ManSEDS-Satellites-and-Space-Systems/CubeSat-EPS/hardware/mount.FCStd

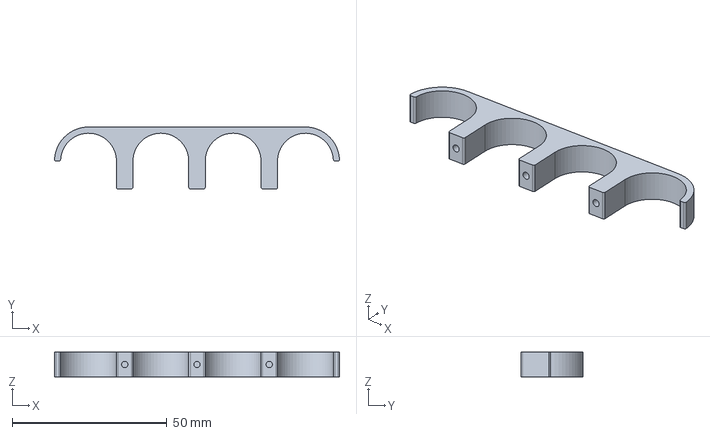
[picture p3: CAD file, 2026-10-23]
hardware/mount.FCStd
92.0 x 20.0 x 8.00 mm
