ManSEDS-Satellites-and-Space-Systems/CubeSat-EPS/hardware/schematic.pdf

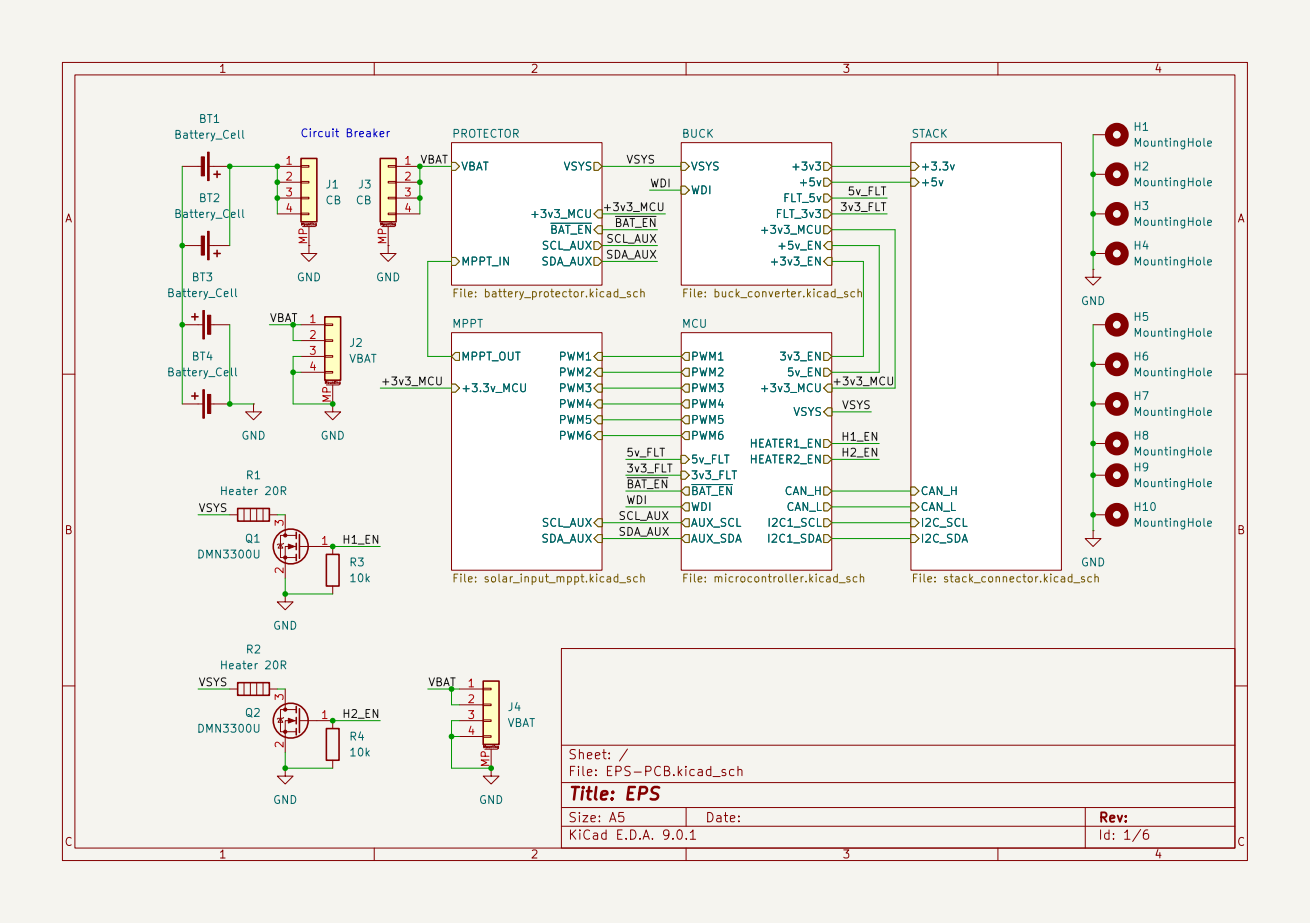
[picture p10: page 1]

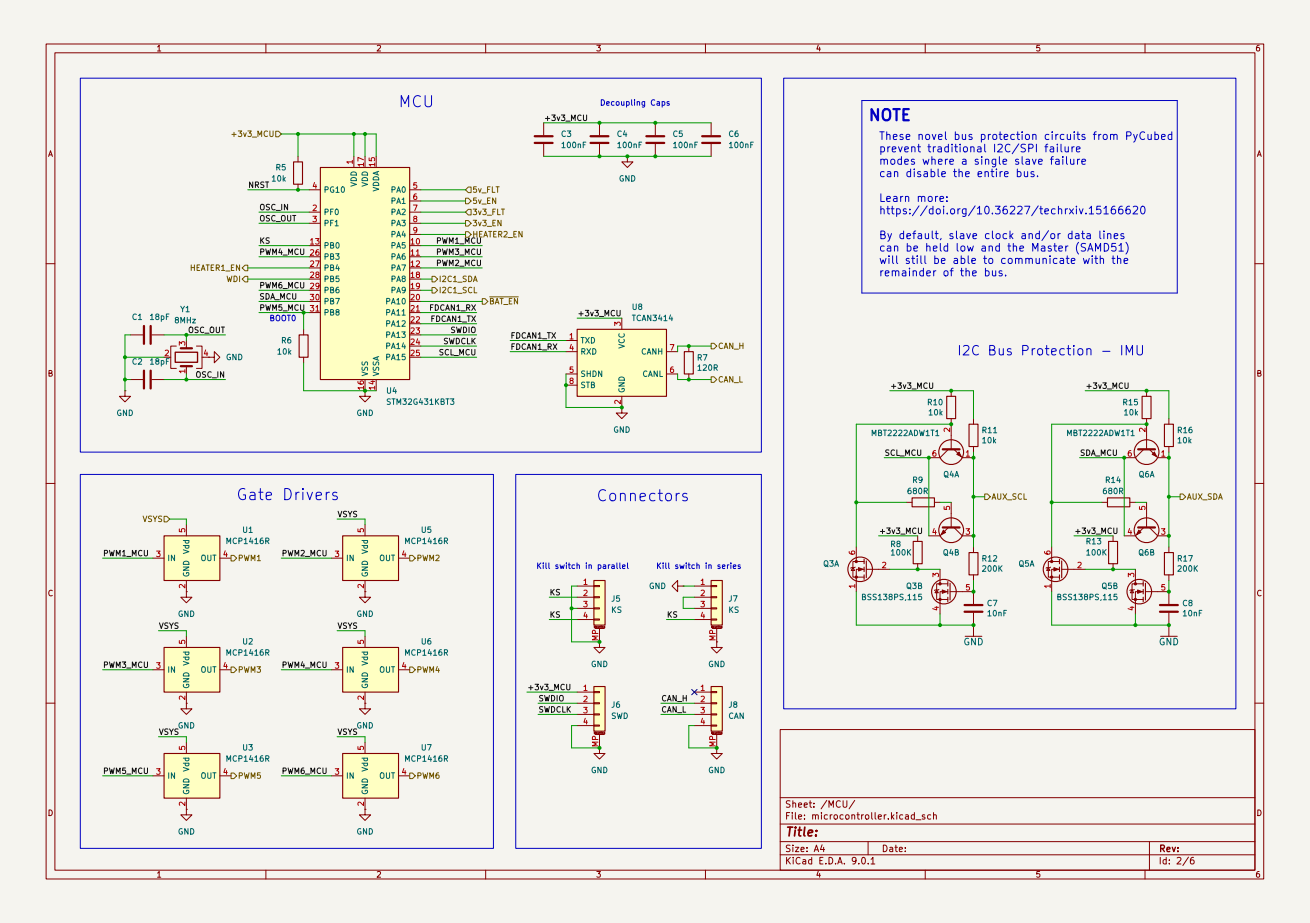
[picture p11: page 2]


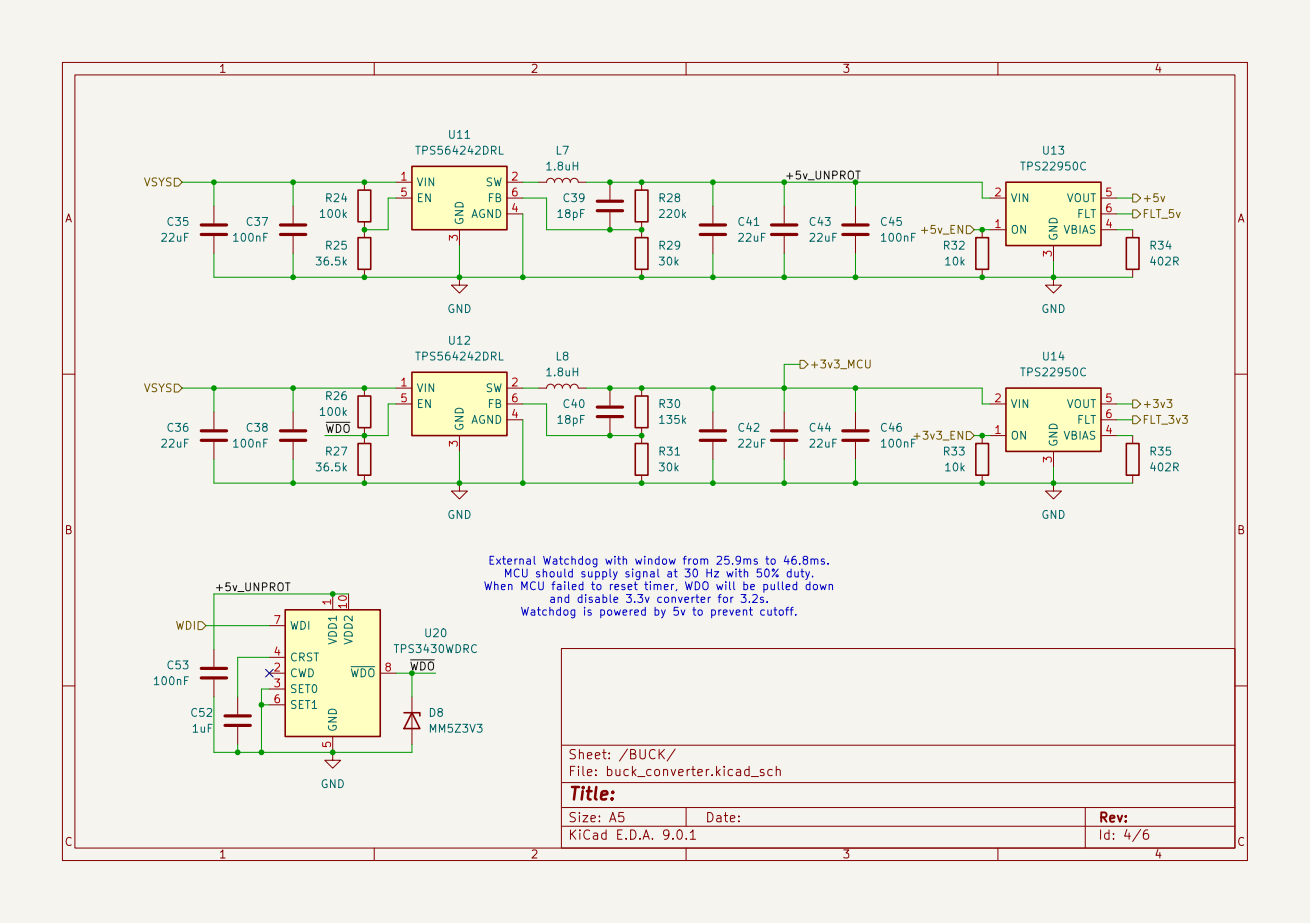
[picture p12: page 4]
