ManSEDS-Satellites-and-Space-Systems/CubeSat-EPS/hardware/EPS-PCB.kicad_pcb

## KiCad design hardware/EPS-PCB.kicad_pcb (2026-11-01)

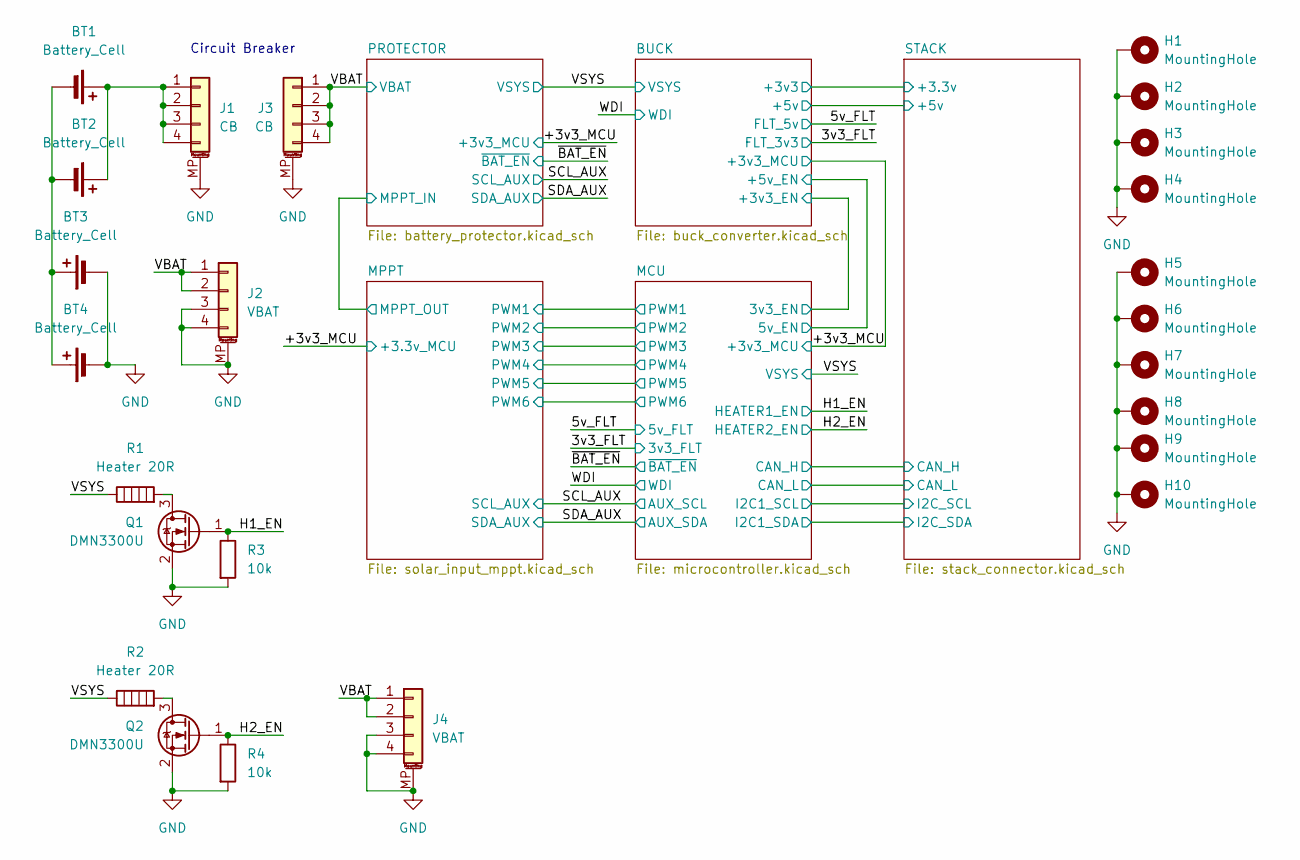
[picture p13: schematic EPS-PCB.kicad_sch, EPS]

Parts:
BT1, BT2, BT3, BT4: Battery_Cell; 18650-THT
H1, H2, H3, H4: MountingHole; MountingHole_3.2mm_M3_DIN965_Pad
H5, H6, H7, H8, H9, H10: MountingHole; MountingHole_2.7mm_M2.5_DIN965_Pad
J1, J3: CB; Molex_Pico-Lock_504050-0491_1x04-1MP_P1.50mm_Horizontal; Mouser Part Number 538-504050-0491
J2, J4: VBAT; Molex_Pico-Lock_504050-0491_1x04-1MP_P1.50mm_Horizontal; Mouser Part Number 538-504050-0491
Q1, Q2: DMN3300U; SOT-23; Mouser Part Number 621-DMN3300U-7
R1, R2: Heater 20R; R_Axial_DIN0617_L17.0mm_D6.0mm_P30.48mm_Horizontal; Mouser Part Number 279-4-2176793-0
R3, R4: 10k; R_0603_1608Metric; Mouser Part Number 603-AC0603DR-0710KL

Connections:
/H1_EN: Q1.1 (G), R3.1; also elsewhere on the board
/H2_EN: Q2.1 (G), R4.1; also elsewhere on the board
/VBAT: J2.1, J2.2, J3.1, J3.2, J3.3, J3.4, J4.1, J4.2; also elsewhere on the board
/VSYS: R1.1, R2.1; also elsewhere on the board
GND: BT3.2 (-), BT4.2 (-), H1.1, H2.1, H3.1, H4.1, H5.1, H6.1, H7.1, H8.1, H9.1, H10.1, J1.MP (MountPin), J2.3, J2.4, J2.MP (MountPin), J3.MP (MountPin), J4.3, J4.4, J4.MP (MountPin), Q1.2 (S), Q2.2 (S), R3.2, R4.2; also elsewhere on the board
unnamed: BT1.1 (+), BT2.1 (+), J1.1, J1.2, J1.3, J1.4
unnamed: BT1.2 (-), BT2.2 (-), BT3.1 (+), BT4.1 (+)
unnamed: Q1.3 (D), R1.2
unnamed: Q2.3 (D), R2.2

Notes on the sheet:
Circuit Breaker

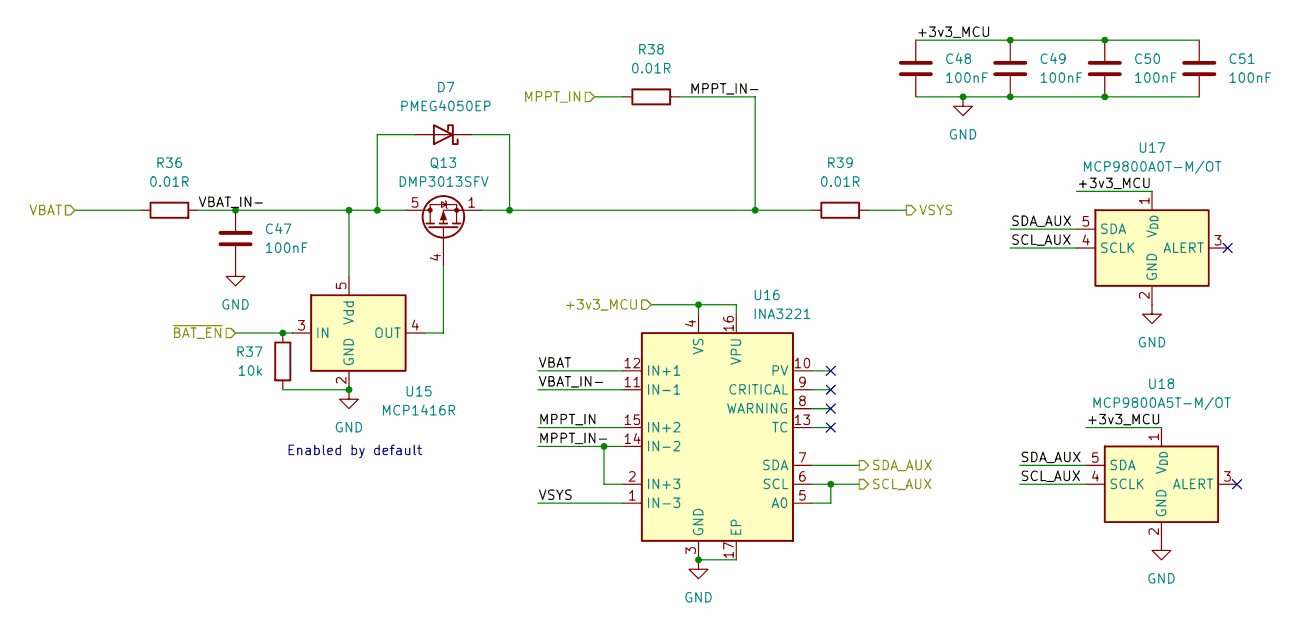
[picture p14: schematic battery_protector.kicad_sch]

Parts:
C47, C48, C49, C50, C51: 100nF; C_0603_1608Metric; Mouser Part Number 603-C0603JRX7R7BB104
D7: PMEG4050EP; D_SOD-128; Mouser Part Number 771-PMEG4050EP115
Q13: DMP3013SFV; Diodes_PowerDI3333-8; Mouser Part Number 621-DMP3013SFV-13
R36, R38, R39: 0.01R; R_0805_2012Metric; Mouser Part Number 603-PA0805FRF870R01L
R37: 10k; R_0603_1608Metric; Mouser Part Number 603-AC0603DR-0710KL
U15: MCP1416R; SOT-23-5; Mouser Part Number 579-MCP1416RT-E/OT
U16: INA3221; Texas_RGV0016A_VQFN-16-1EP_4x4mm_P0.65mm_EP2.1x2.1mm; Mouser Part Number 595-INA3221AIRGVR
U17: MCP9800A0T-M/OT; SOT-23-5; Mouser Part Number 579-MCP9800A0T-M/OT
U18: MCP9800A5T-M/OT; SOT-23-5; Mouser Part Number 579-MCP9800A5T-M/OT

Connections:
/+3v3_MCU: C48.1, C49.1, C50.1, C51.1, U16.4 (VS), U16.16 (VPU), U17.1 (V_{DD}), U18.1 (V_{DD}); also elsewhere on the board
/MPPT/MPPT_OUT: R38.1, U16.15 (IN+2); also elsewhere on the board
/PROTECTOR/MPPT_IN-: D7.1 (K), Q13.1 (S), Q13.2 (S), Q13.3 (S), R38.2, R39.1, U16.2 (IN+3), U16.14 (IN-2)
/PROTECTOR/VBAT_IN-: C47.1, D7.2 (A), Q13.5 (D), R36.2, U15.5 (Vdd), U16.11 (IN-1)
/SCL_AUX: U16.5 (A0), U16.6 (SCL), U17.4 (SCLK), U18.4 (SCLK); also elsewhere on the board
/SDA_AUX: U16.7 (SDA), U17.5 (SDA), U18.5 (SDA); also elsewhere on the board
/VBAT: R36.1, U16.12 (IN+1); also elsewhere on the board
/VSYS: R39.2, U16.1 (IN-3); also elsewhere on the board
/~BAT_EN: R37.1, U15.3 (IN); also elsewhere on the board
GND: C47.2, C48.2, C49.2, C50.2, C51.2, R37.2, U15.2 (GND), U16.3 (GND), U16.17 (EP), U17.2 (GND), U18.2 (GND); also elsewhere on the board
unnamed: Q13.4 (G), U15.4 (OUT)

Notes on the sheet:
Enabled by default

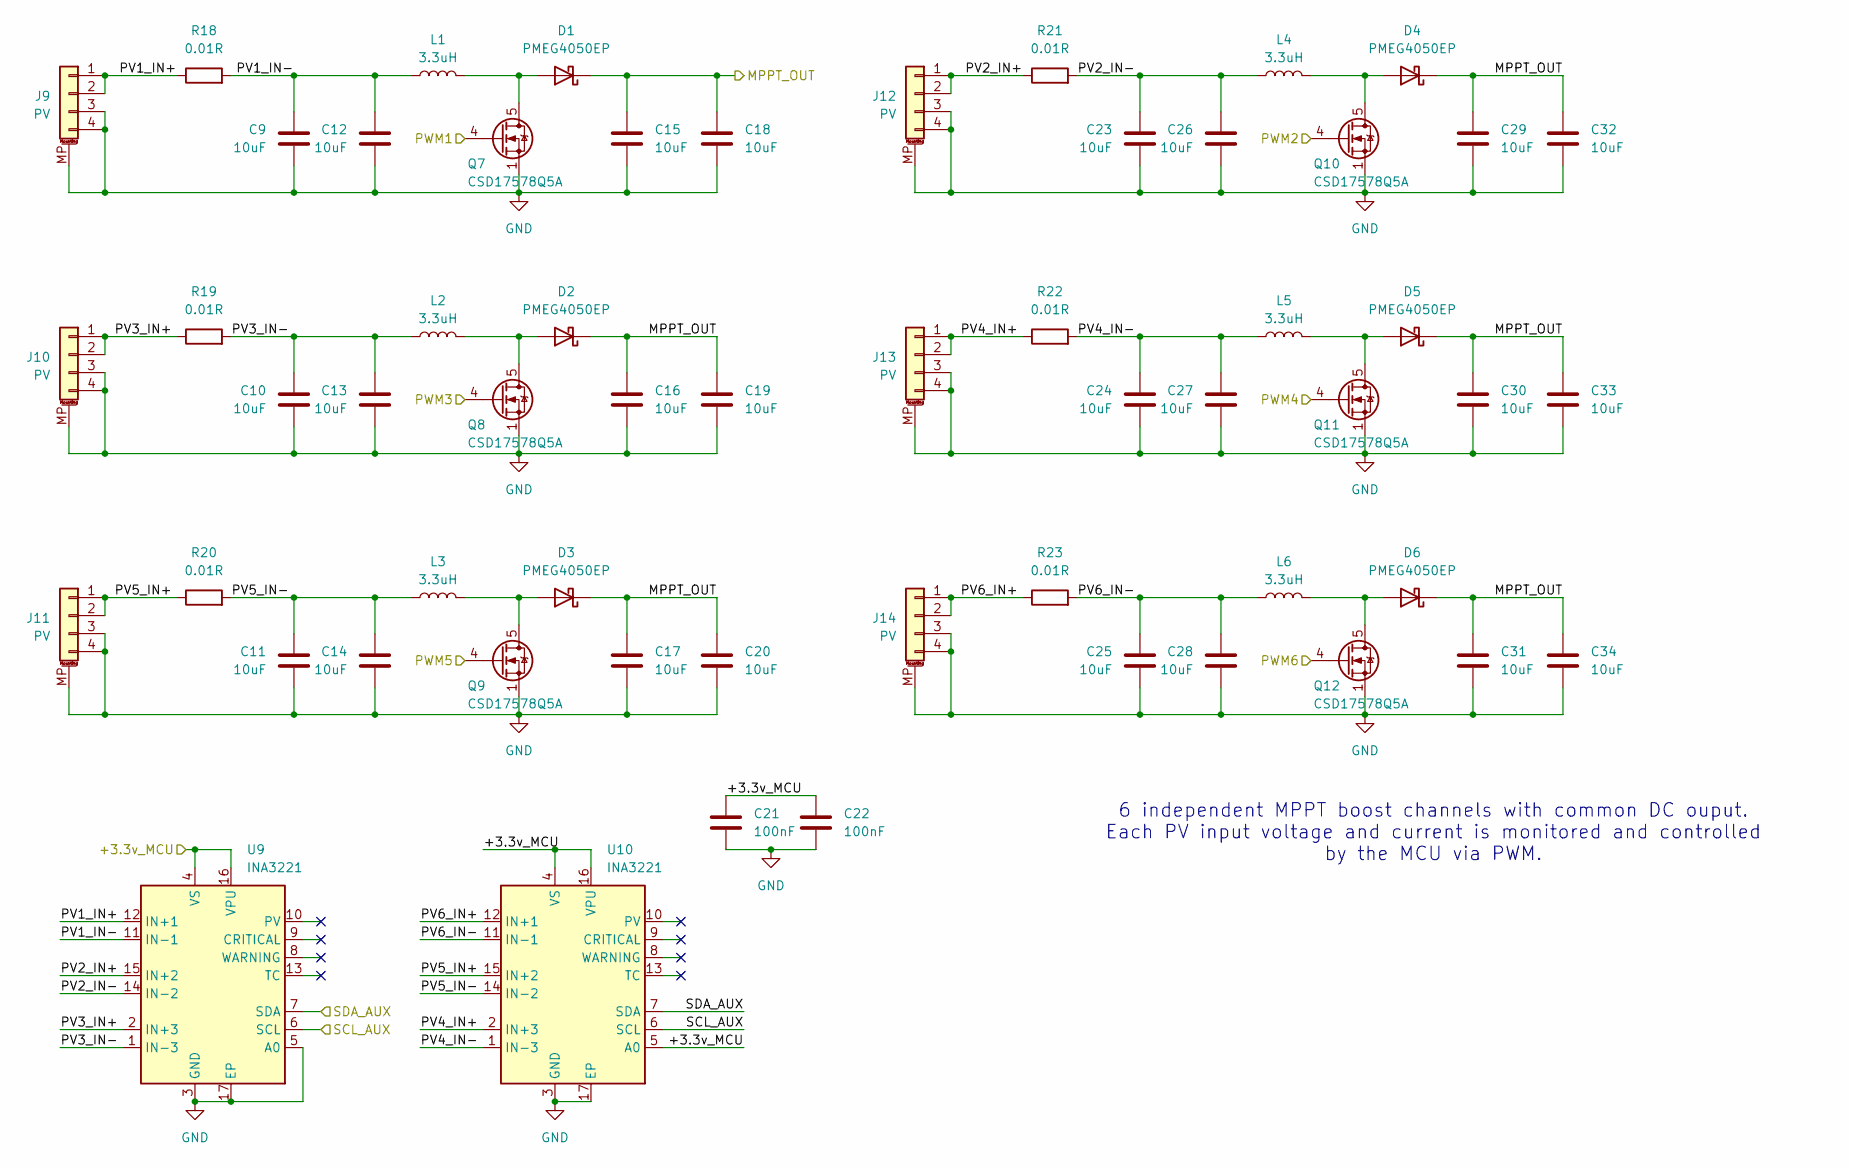
[picture p15: schematic solar_input_mppt.kicad_sch]

Parts:
C9, C10, C11, C12, C13, C14, C15, C16, C17, C18, C19, C20, C23, C24, C25, C26, C27, C28, C29, C30, C31, C32, C33, C34: 10uF; C_0603_1608Metric; Mouser Part Number 81-GRM188R61C106MALJ
C21, C22: 100nF; C_0603_1608Metric; Mouser Part Number 603-C0603JRX7R7BB104
D1, D2, D3, D4, D5, D6: PMEG4050EP; D_SOD-128; Mouser Part Number 771-PMEG4050EP115
J9, J10, J11, J12, J13, J14: PV; Molex_Pico-Lock_504050-0491_1x04-1MP_P1.50mm_Horizontal; Mouser Part Number 538-504050-0491
L1, L2, L3, L4, L5, L6: 3.3uH; L_Vishay_IHLP-2020; Mouser Part Number 70-IHLP2020BZER3R3M1
Q7, Q8, Q9, Q10, Q11, Q12: CSD17578Q5A; TDSON-8-1; Mouser Part Number 595-CSD17578Q5A
R18, R19, R20, R21, R22, R23: 0.01R; R_0805_2012Metric; Mouser Part Number 603-PA0805FRF870R01L
U9, U10: INA3221; Texas_RGV0016A_VQFN-16-1EP_4x4mm_P0.65mm_EP2.1x2.1mm; Mouser Part Number 595-INA3221AIRGVR

Connections:
/+3v3_MCU: C21.1, C22.1, U9.4 (VS), U9.16 (VPU), U10.4 (VS), U10.5 (A0), U10.16 (VPU); also elsewhere on the board
/MCU/PWM1: Q7.4 (G); also elsewhere on the board
/MCU/PWM2: Q10.4 (G); also elsewhere on the board
/MCU/PWM3: Q8.4 (G); also elsewhere on the board
/MCU/PWM4: Q11.4 (G); also elsewhere on the board
/MCU/PWM5: Q9.4 (G); also elsewhere on the board
/MCU/PWM6: Q12.4 (G); also elsewhere on the board
/MPPT/MPPT_OUT: C15.1, C16.1, C17.1, C18.1, C19.1, C20.1, C29.1, C30.1, C31.1, C32.1, C33.1, C34.1, D1.1 (K), D2.1 (K), D3.1 (K), D4.1 (K), D5.1 (K), D6.1 (K); also elsewhere on the board
/MPPT/PV1_IN+: J9.1, J9.2, R18.1, U9.12 (IN+1)
/MPPT/PV1_IN-: C9.1, C12.1, L1.1, R18.2, U9.11 (IN-1)
/MPPT/PV2_IN+: J12.1, J12.2, R21.1, U9.15 (IN+2)
/MPPT/PV2_IN-: C23.1, C26.1, L4.1, R21.2, U9.14 (IN-2)
/MPPT/PV3_IN+: J10.1, J10.2, R19.1, U9.2 (IN+3)
/MPPT/PV3_IN-: C10.1, C13.1, L2.1, R19.2, U9.1 (IN-3)
/MPPT/PV4_IN+: J13.1, J13.2, R22.1, U10.2 (IN+3)
/MPPT/PV4_IN-: C24.1, C27.1, L5.1, R22.2, U10.1 (IN-3)
/MPPT/PV5_IN+: J11.1, J11.2, R20.1, U10.15 (IN+2)
/MPPT/PV5_IN-: C11.1, C14.1, L3.1, R20.2, U10.14 (IN-2)
/MPPT/PV6_IN+: J14.1, J14.2, R23.1, U10.12 (IN+1)
/MPPT/PV6_IN-: C25.1, C28.1, L6.1, R23.2, U10.11 (IN-1)
/SCL_AUX: U9.6 (SCL), U10.6 (SCL); also elsewhere on the board
/SDA_AUX: U9.7 (SDA), U10.7 (SDA); also elsewhere on the board
GND: C9.2, C10.2, C11.2, C12.2, C13.2, C14.2, C15.2, C16.2, C17.2, C18.2, C19.2, C20.2, C21.2, C22.2, C23.2, C24.2, C25.2, C26.2, C27.2, C28.2, C29.2, C30.2, C31.2, C32.2, C33.2, C34.2, J9.3, J9.4, J9.MP (MountPin), J10.3, J10.4, J10.MP (MountPin), J11.3, J11.4, J11.MP (MountPin), J12.3, J12.4, J12.MP (MountPin), J13.3, J13.4, J13.MP (MountPin), J14.3, J14.4, J14.MP (MountPin), Q7.1 (S), Q7.2 (S), Q7.3 (S), Q8.1 (S), Q8.2 (S), Q8.3 (S), Q9.1 (S), Q9.2 (S), Q9.3 (S), Q10.1 (S), Q10.2 (S), Q10.3 (S), Q11.1 (S), Q11.2 (S), Q11.3 (S), Q12.1 (S), Q12.2 (S), Q12.3 (S), U9.3 (GND), U9.5 (A0), U9.17 (EP), U10.3 (GND), U10.17 (EP); also elsewhere on the board
unnamed: D1.2 (A), L1.2, Q7.5 (D)
unnamed: D2.2 (A), L2.2, Q8.5 (D)
unnamed: D3.2 (A), L3.2, Q9.5 (D)
unnamed: D4.2 (A), L4.2, Q10.5 (D)
unnamed: D5.2 (A), L5.2, Q11.5 (D)
unnamed: D6.2 (A), L6.2, Q12.5 (D)

Notes on the sheet:
6 independent MPPT boost channels with common DC ouput. Each PV input voltage and current is monitored and controlled by the MCU via PWM.

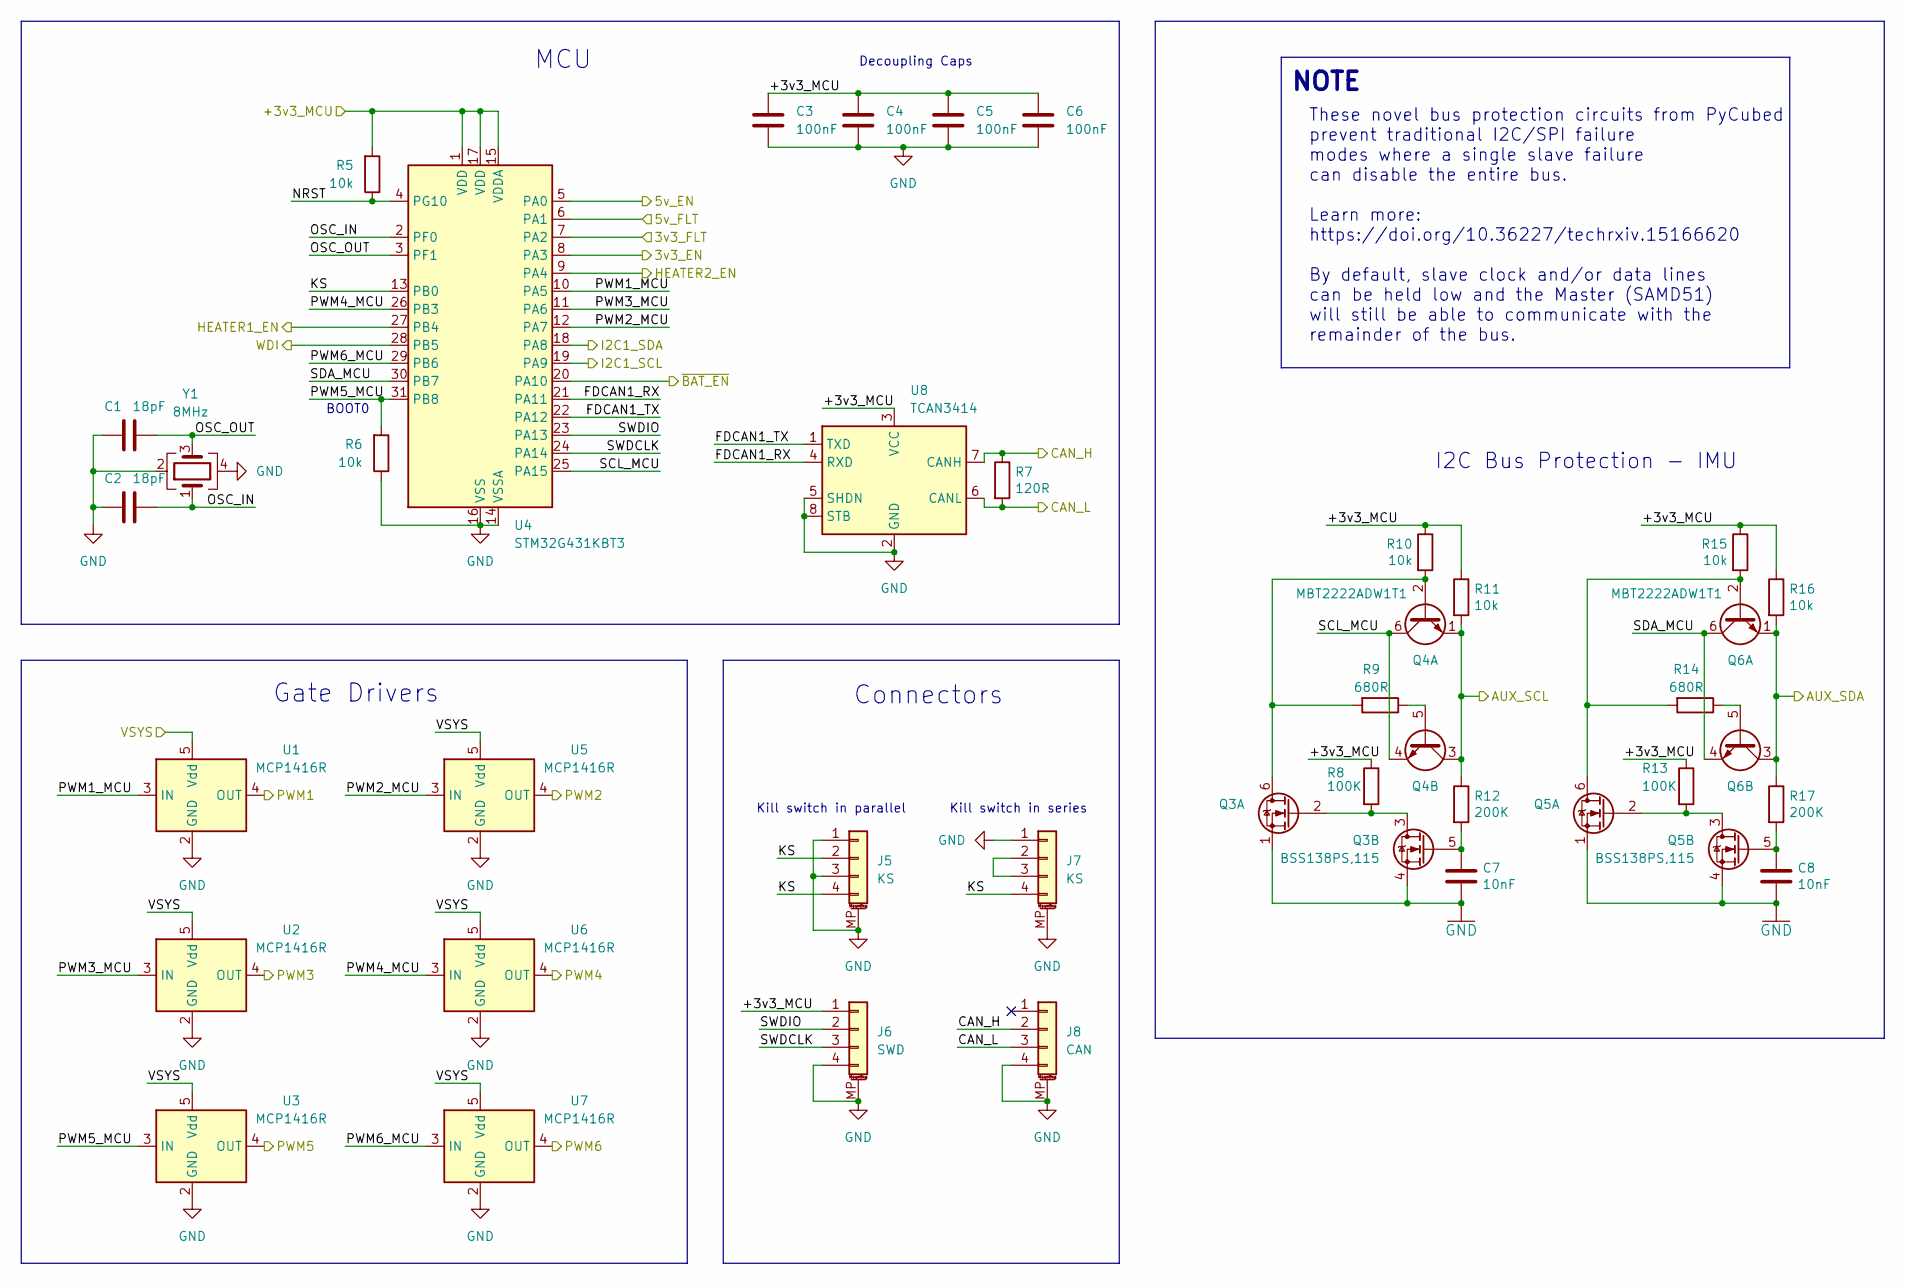
[picture p16: schematic microcontroller.kicad_sch]

Parts:
C1, C2: 18pF; C_0603_1608Metric; Mouser Part Number 603-CC603FRNPO9BN180
C3, C4, C5, C6: 100nF; C_0603_1608Metric; Mouser Part Number 603-C0603JRX7R7BB104
C7, C8: 10nF; C_0603_1608Metric; Mouser Part Number 603-CC0603JR7R7BB103; LCSC C1589
J5, J7: KS; Molex_Pico-Lock_504050-0491_1x04-1MP_P1.50mm_Horizontal; Mouser Part Number 538-504050-0491
J6: SWD; Molex_Pico-Lock_504050-0491_1x04-1MP_P1.50mm_Horizontal; Mouser Part Number 538-504050-0491
J8: CAN; Molex_Pico-Lock_504050-0491_1x04-1MP_P1.50mm_Horizontal; Mouser Part Number 538-504050-0491
Q3, Q5: BSS138PS,115; SOT-363_SC-70-6; Mouser Part Number 771-BSS138PS115
Q4, Q6: MBT2222ADW1T1; SOT-363_SC-70-6; Mouser Part Number 863-MBT2222ADW1T1G
R5, R6: 10k; R_0603_1608Metric; Mouser Part Number 603-AC0603DR-0710KL
R7: 120R; R_0603_1608Metric; Mouser Part Number 603-AC0603FR-07120RL; LCSC C118142
R8, R13: 100K; R_0603_1608Metric; Mouser Part Number 603-AC0603FR-7W100KL; LCSC C5369222
R9, R14: 680R; R_0603_1608Metric; Mouser Part Number 603-RT0603FRE13680RL; LCSC C112310
R10, R11, R15, R16: 10k; R_0603_1608Metric; Mouser Part Number 603-AC0603DR-0710KL; LCSC C191124
R12, R17: 200K; R_0603_1608Metric; Mouser Part Number 603-RT0603DRE07200KL; LCSC C118142
U1, U2, U3, U5, U6, U7: MCP1416R; SOT-23-5; Mouser Part Number 579-MCP1416RT-E/OT
U4: STM32G431KBT3; LQFP-32_7x7mm_P0.8mm; Mouser Part Number 511-STM32G431KBT3
U8: TCAN3414; SOIC-8_3.9x4.9mm_P1.27mm; Mouser Part Number 595-TCAN3414DRBR
Y1: 8MHz; Crystal_SMD_3225-4Pin_3.2x2.5mm; Mouser Part Number 815-M8AIG-8-1ZT

Connections:
/3v3_FLT: U4.7 (PA2); also elsewhere on the board
/5v_FLT: U4.6 (PA1); also elsewhere on the board
/+3v3_MCU: C3.1, C4.1, C5.1, C6.1, J6.1, R5.2, R8.1, R10.1, R11.1, R13.1, R15.1, R16.1, U4.1 (VDD), U4.15 (VDDA), U4.17 (VDD), U8.3 (VCC); also elsewhere on the board
/BUCK/+3v3_EN: U4.8 (PA3); also elsewhere on the board
/BUCK/+5v_EN: U4.5 (PA0); also elsewhere on the board
/H1_EN: U4.27 (PB4); also elsewhere on the board
/H2_EN: U4.9 (PA4); also elsewhere on the board
/MCU/CAN_H: J8.2, R7.1, U8.7 (CANH); also elsewhere on the board
/MCU/CAN_L: J8.3, R7.2, U8.6 (CANL); also elsewhere on the board
/MCU/FDCAN1_RX: U4.21 (PA11), U8.4 (RXD)
/MCU/FDCAN1_TX: U4.22 (PA12), U8.1 (TXD)
/MCU/I2C1_SCL: U4.19 (PA9); also elsewhere on the board
/MCU/I2C1_SDA: U4.18 (PA8); also elsewhere on the board
/MCU/KS: J5.2, J5.4, J7.4, U4.13 (PB0)
/MCU/NRST: R5.1, U4.4 (PG10)
/MCU/OSC_IN: C2.2, U4.2 (PF0), Y1.1
/MCU/OSC_OUT: C1.2, U4.3 (PF1), Y1.3
/MCU/PWM1: U1.4 (OUT); also elsewhere on the board
/MCU/PWM1_MCU: U1.3 (IN), U4.10 (PA5)
/MCU/PWM2: U5.4 (OUT); also elsewhere on the board
/MCU/PWM2_MCU: U4.12 (PA7), U5.3 (IN)
/MCU/PWM3: U2.4 (OUT); also elsewhere on the board
/MCU/PWM3_MCU: U2.3 (IN), U4.11 (PA6)
/MCU/PWM4: U6.4 (OUT); also elsewhere on the board
/MCU/PWM4_MCU: U4.26 (PB3), U6.3 (IN)
/MCU/PWM5: U3.4 (OUT); also elsewhere on the board
/MCU/PWM5_MCU: R6.2, U3.3 (IN), U4.31 (PB8)
/MCU/PWM6: U7.4 (OUT); also elsewhere on the board
/MCU/PWM6_MCU: U4.29 (PB6), U7.3 (IN)
/MCU/SCL_MCU: Q4.4 (E2), Q4.6 (C1), U4.25 (PA15)
/MCU/SDA_MCU: Q6.4 (E2), Q6.6 (C1), U4.30 (PB7)
/MCU/SWDCLK: J6.3, U4.24 (PA14)
/MCU/SWDIO: J6.2, U4.23 (PA13)
/SCL_AUX: Q4.1 (E1), Q4.3 (C2), R11.2, R12.1; also elsewhere on the board
/SDA_AUX: Q6.1 (E1), Q6.3 (C2), R16.2, R17.1; also elsewhere on the board
/VSYS: U1.5 (Vdd), U2.5 (Vdd), U3.5 (Vdd), U5.5 (Vdd), U6.5 (Vdd), U7.5 (Vdd); also elsewhere on the board
/WDI: U4.28 (PB5); also elsewhere on the board
/~BAT_EN: U4.20 (PA10); also elsewhere on the board
GND: C1.1, C2.1, C3.2, C4.2, C5.2, C6.2, C7.2, C8.2, J5.1, J5.3, J5.MP (MountPin), J6.4, J6.MP (MountPin), J7.1, J7.MP (MountPin), J8.4, J8.MP (MountPin), Q3.1 (S), Q3.4 (S), Q5.1 (S), Q5.4 (S), R6.1, U1.2 (GND), U2.2 (GND), U3.2 (GND), U4.14 (VSSA), U4.16 (VSS), U4.32 (VSS), U5.2 (GND), U6.2 (GND), U7.2 (GND), U8.2 (GND), U8.5 (SHDN), U8.8 (STB), Y1.2, Y1.4; also elsewhere on the board
unnamed: J7.2, J7.3
unnamed: Q3.6 (D), Q4.2 (B1), R9.2, R10.2
unnamed: Q3.2 (G), Q3.3 (D), R8.2
unnamed: C7.1, Q3.5 (G), R12.2
unnamed: Q4.5 (B2), R9.1
unnamed: Q5.6 (D), Q6.2 (B1), R14.2, R15.2
unnamed: Q5.2 (G), Q5.3 (D), R13.2
unnamed: C8.1, Q5.5 (G), R17.2
unnamed: Q6.5 (B2), R14.1

Notes on the sheet:
BOOT0
Kill switch in series
NOTE
I2C Bus Protection - IMU
Decoupling Caps
These novel bus protection circuits from PyCubed prevent traditional I2C/SPI failure modes where a single slave failure can disable the entire bus. Learn more: https://doi.org/10.36227/techrxiv.15166620 By default, slave clock and/or data lines can be held low and the Master (SAMD51) will still be 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
Connectors
MCU
Kill switch in parallel
Gate Drivers

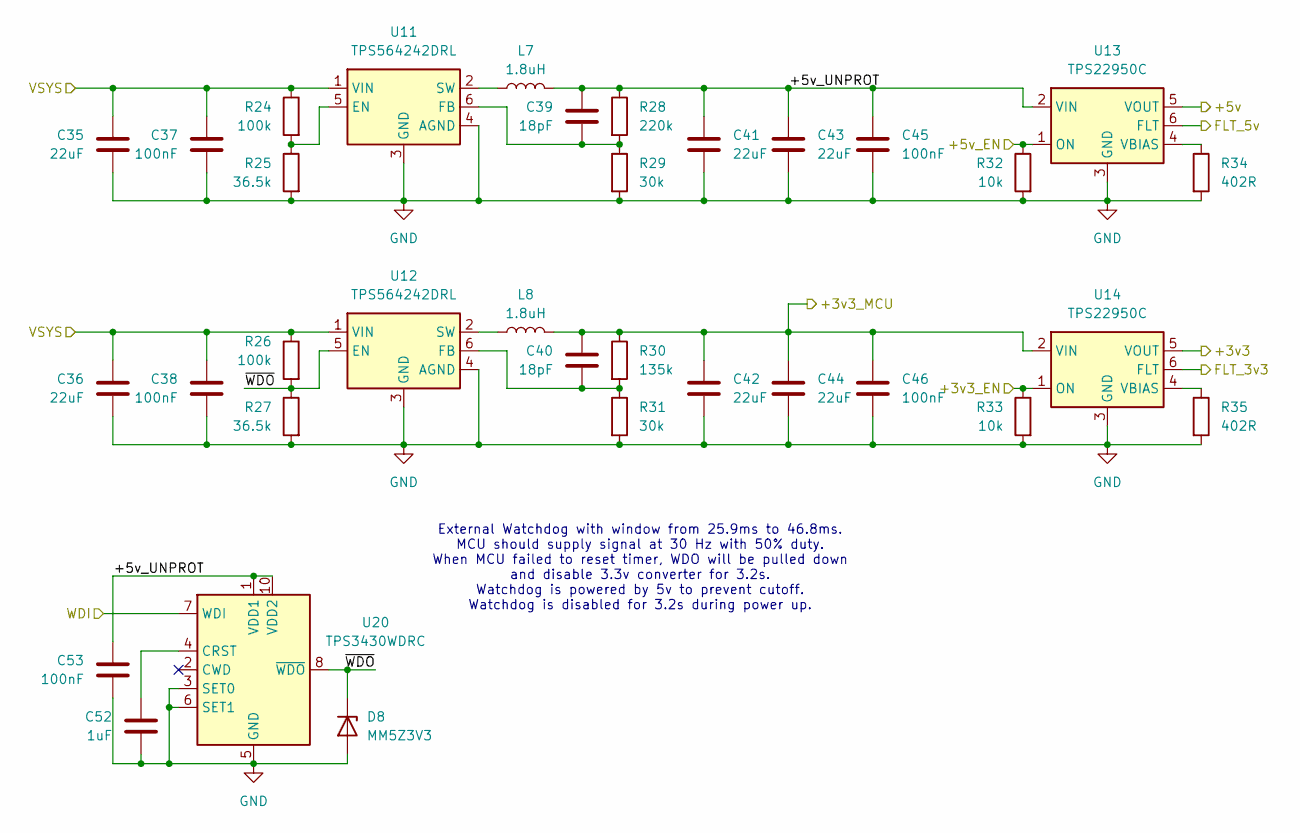
[picture p17: schematic buck_converter.kicad_sch]

Parts:
C35, C36, C41, C42, C43, C44: 22uF; C_0603_1608Metric; Mouser Part Number 81-ZRB18AR61C226ME1L
C37, C38, C45, C46, C53: 100nF; C_0603_1608Metric; Mouser Part Number 603-C0603JRX7R7BB104
C39, C40: 18pF; C_0603_1608Metric; Mouser Part Number 603-CC603FRNPO9BN180
C52: 1uF; C_0603_1608Metric; Mouser Part Number 603-CC603KRX5R6BB105
D8: MM5Z3V3; D_SOD-523; Mouser Part Number 637-MM5Z3V3
L7, L8: 1.8uH; L_Coilcraft_XAL6030-XXX; Mouser Part Number 994-XAL6030-182MEC
R24, R26: 100k; R_0603_1608Metric; Mouser Part Number 603-AC0603FR-7W100KL
R25, R27: 36.5k; R_0603_1608Metric; Mouser Part Number 603-RT0603DRE0736K5L
R28: 220k; R_0603_1608Metric; Mouser Part Number 603-RC0603FR-07220KL
R29, R31: 30k; R_0603_1608Metric; Mouser Part Number 603-AC0603DR-0730KL
R30: 135k; R_0603_1608Metric; Mouser Part Number 603-RT0603BRD07135KL
R32, R33: 10k; R_0603_1608Metric; Mouser Part Number 603-AC0603DR-0710KL
R34, R35: 402R; R_0603_1608Metric; Mouser Part Number 603-RT0603DRD07402RL
U11, U12: TPS564242DRL; SOT-563; Mouser Part Number 595-TPS564242DRLR
U13, U14: TPS22950C; SOT-23-6; Mouser Part Number 595-TPS22950CDDCR
U20: TPS3430WDRC; VSON-10-1EP_3x3mm_P0.5mm_EP1.65x2.4mm; Mouser Part Number 595-TPS3430WDRCR

Connections:
/3v3_FLT: U14.6 (FLT); also elsewhere on the board
/5v_FLT: U13.6 (FLT); also elsewhere on the board
/+3v3_MCU: C40.1, C42.1, C44.1, C46.1, L8.2, R30.1, U14.2 (VIN); also elsewhere on the board
/BUCK/+3v3_EN: R33.1, U14.1 (ON); also elsewhere on the board
/BUCK/+5v_EN: R32.1, U13.1 (ON); also elsewhere on the board
/BUCK/+5v_UNPROT: C39.1, C41.1, C43.1, C45.1, C53.1, L7.2, R28.1, U13.2 (VIN), U20.1 (VDD1), U20.10 (VDD2)
/BUCK/~WDO: D8.1 (K), R26.2, R27.1, U12.5 (EN), U20.8 (~WDO)
/STACK/+3.3v: U14.5 (VOUT); also elsewhere on the board
/STACK/+5v: U13.5 (VOUT); also elsewhere on the board
/VSYS: C35.1, C36.1, C37.1, C38.1, R24.1, R26.1, U11.1 (VIN), U12.1 (VIN); also elsewhere on the board
/WDI: U20.7 (WDI); also elsewhere on the board
GND: C35.2, C36.2, C37.2, C38.2, C41.2, C42.2, C43.2, C44.2, C45.2, C46.2, C52.2, C53.2, D8.2 (A), R25.2, R27.2, R29.2, R31.2, R32.2, R33.2, R34.2, R35.2, U11.3 (GND), U11.4 (AGND), U12.3 (GND), U12.4 (AGND), U13.3 (GND), U14.3 (GND), U20.3 (SET0), U20.5 (GND), U20.6 (SET1), U20.11 (GND); also elsewhere on the board
unnamed: R24.2, R25.1, U11.5 (EN)
unnamed: C39.2, R28.2, R29.1, U11.6 (FB)
unnamed: L7.1, U11.2 (SW)
unnamed: C40.2, R30.2, R31.1, U12.6 (FB)
unnamed: L8.1, U12.2 (SW)
unnamed: R34.1, U13.4 (VBIAS)
unnamed: R35.1, U14.4 (VBIAS)
unnamed: C52.1, U20.4 (CRST)

Notes on the sheet:
External Watchdog with window from 25.9ms to 46.8ms. MCU should supply signal at 30 Hz with 50% duty. When MCU failed to reset timer, WDO will be pulled down and disable 3.3v converter for 3.2s. Watchdog is powered by 5v to prevent cutoff. Watchdog is disabled for 3.2s during power up.

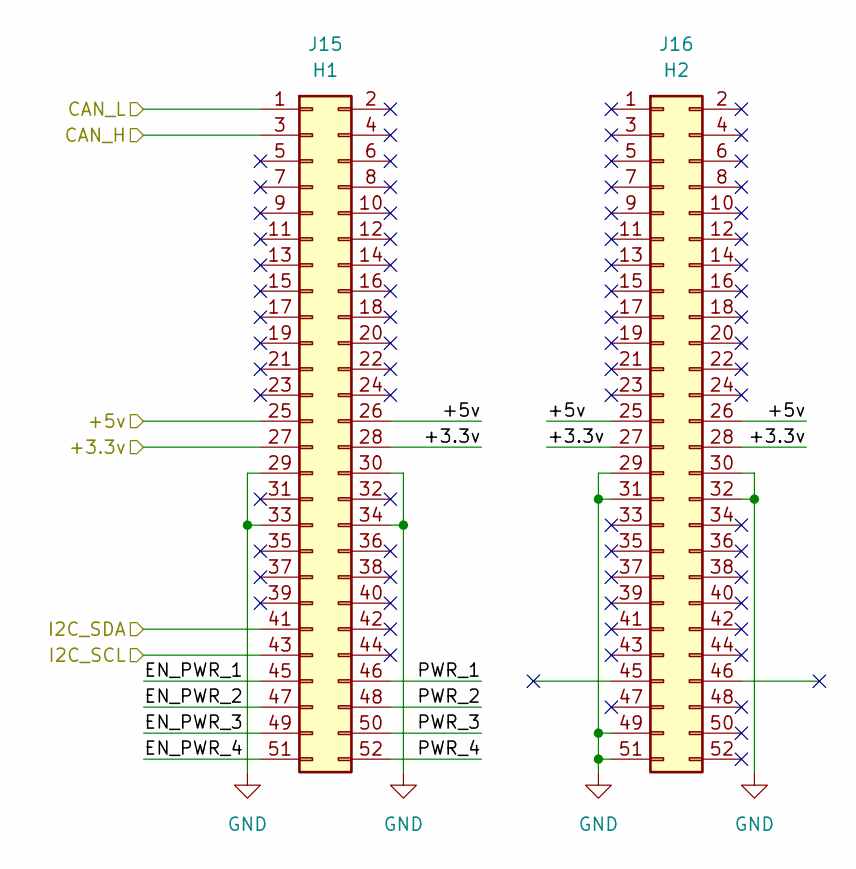
[picture p18: schematic stack_connector.kicad_sch]

Parts:
J15: H1; PinHeader_2x26_P2.54mm_Vertical
J16: H2; PinHeader_2x26_P2.54mm_Vertical

Connections:
/MCU/CAN_H: J15.3; also elsewhere on the board
/MCU/CAN_L: J15.1; also elsewhere on the board
/MCU/I2C1_SCL: J15.43; also elsewhere on the board
/MCU/I2C1_SDA: J15.41; also elsewhere on the board
/STACK/+3.3v: J15.27, J15.28, J16.27, J16.28; also elsewhere on the board
/STACK/+5v: J15.25, J15.26, J16.25, J16.26; also elsewhere on the board
/STACK/EN_PWR_1: J15.45
/STACK/EN_PWR_2: J15.47
/STACK/EN_PWR_3: J15.49
/STACK/EN_PWR_4: J15.51
/STACK/PWR_1: J15.46
/STACK/PWR_2: J15.48
/STACK/PWR_3: J15.50
/STACK/PWR_4: J15.52
GND: J15.29, J15.30, J15.33, J15.34, J16.29, J16.30, J16.31, J16.32, J16.49, J16.51; also elsewhere on the board

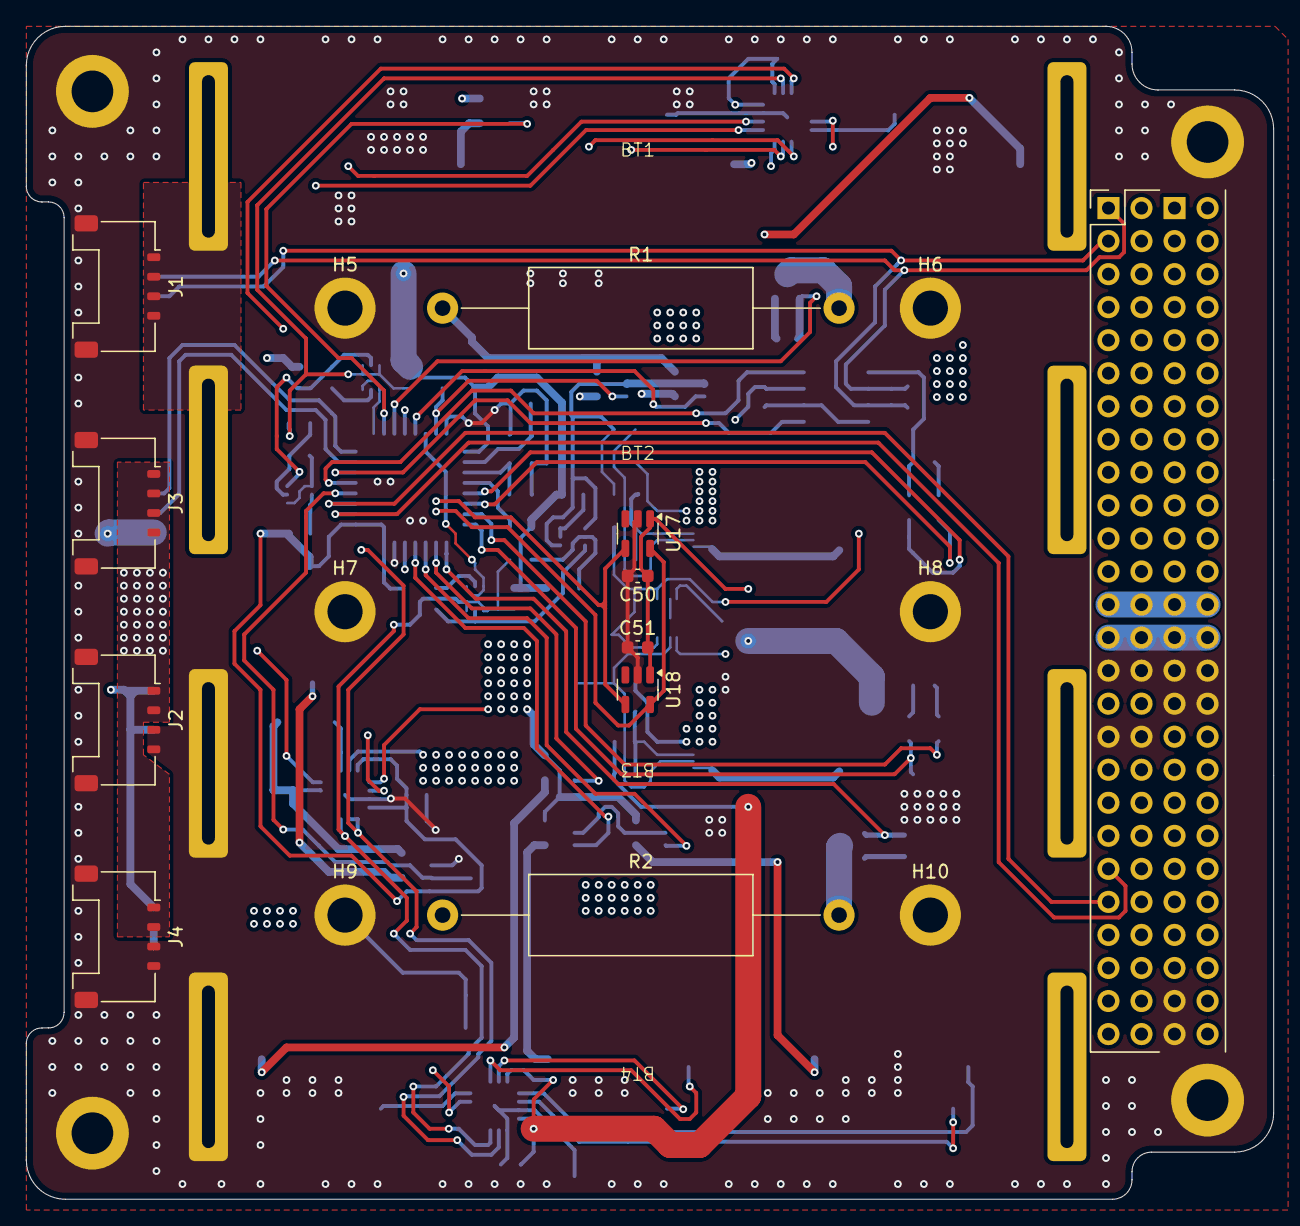
[picture p19: board EPS-PCB.kicad_pcb from above]

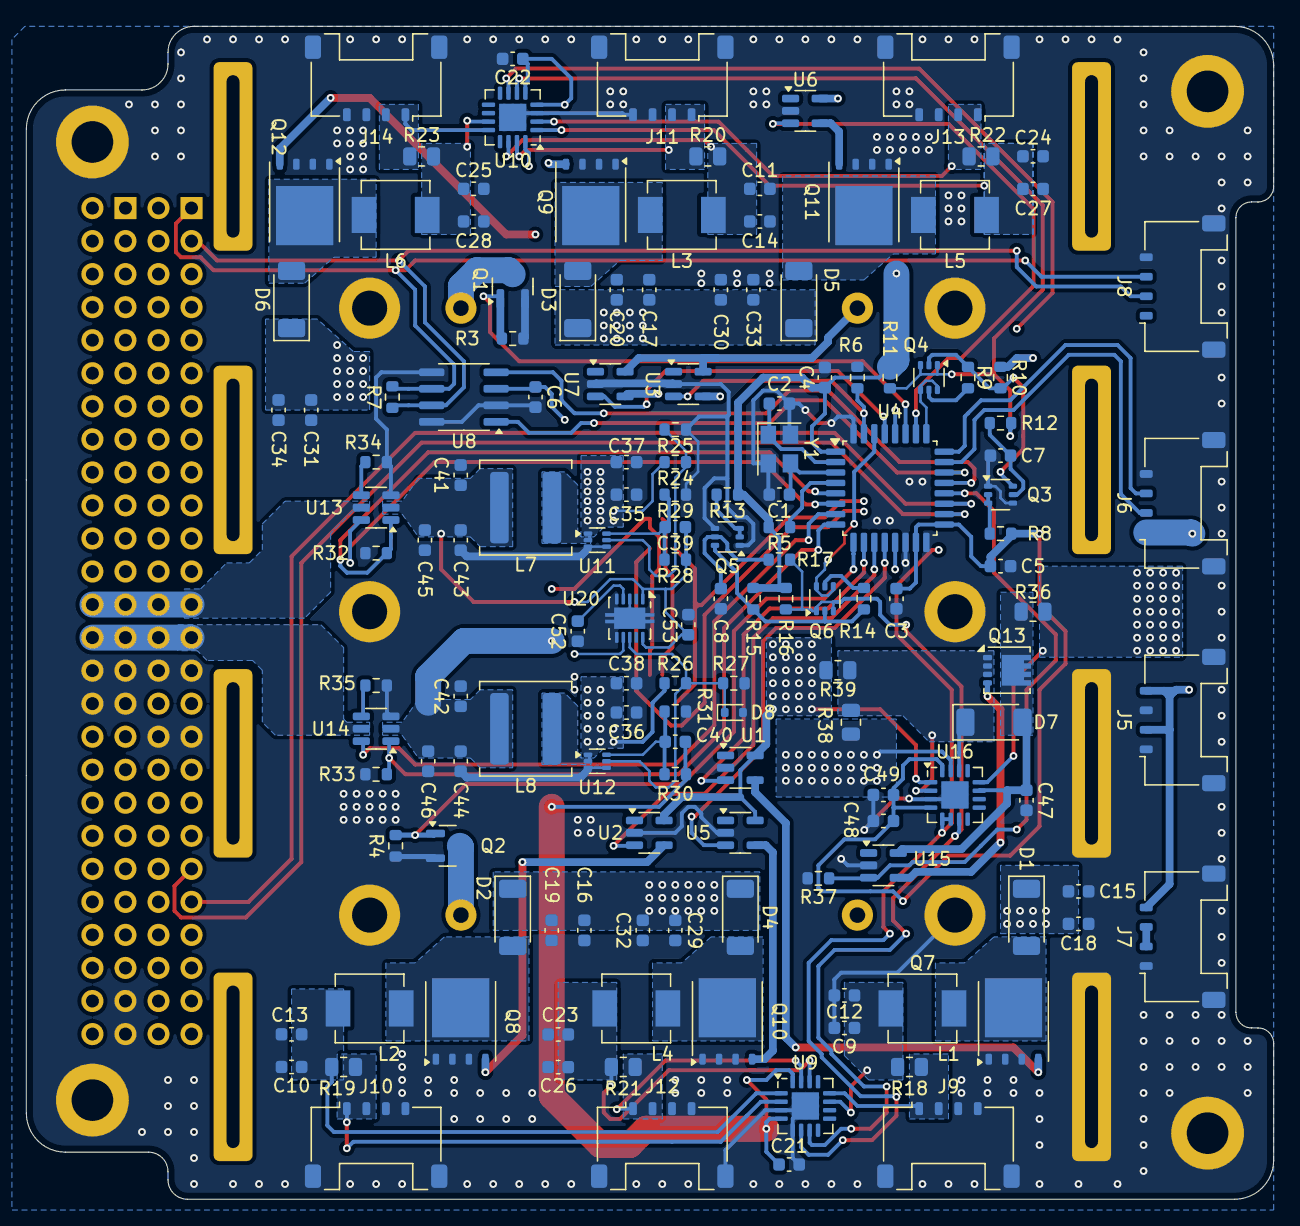
[picture p20: board EPS-PCB.kicad_pcb from below]

Board: 4 copper layers, 95.9 x 90.2 mm, 171 parts (145 on the bottom side), 87 nets.
