ManSEDS-Satellites-and-Space-Systems/CubeSat-EPS/(commit log)

2026-10-23 Added battery mounts
2026-11-01 Implement battery charge and fix killswitch interrupt conflict
2026-11-01 Switch to P&O MPPT implementation
